BB-8-Senior-Design/pcb/Main_Board.brd

## EAGLE design Main_Board.brd (2016-10-18)

Schematic: Main_Board.sch

Parts:
C1, C3: 10uF; RADIAL_CAN_SMD-B
C2, C4, C5: 100uF; RADIAL_CAN_SMD-D8
C6, C7, C42: 470nF; 0805
C8, C9: 470uF; RADIAL_CAN_SMD-G
C10, C61, C68: 1uF; 0805
C11: .1uF; 0805
C12, C13: 6.8pF; 0805
C14, C15: 20pF; 0805
C16, C20, C21, C22, C23, C24, C41: 100nF; 0805
C17, C18, C56, C70: 2.2uF; 0805
C19, C63: 10uF; 0805
C25, C38, C39: 4.7uF; 0805
C26, C35, C36, C37, C46, C47, C48, C49, C50, C51, C52, C53, C54, C55, C57, C58, C59, C60, C62, C64, C66, C67, C69, C73, C74, C75, C76, C77, C78: 0.1uF; 0805
C27: 270nF; 0805
C28: 2.7nF; 0805
C29, C32: 22nF; 0805
C30, C31: 10nF; 0805
C33, C34: 0.47uF; 0805
C40: 150pF; 0805
C43: 10pF; 0805
C44: 47uF; 1206-CAP
C45, C72: 22uF; 0805
C65: 1.5uF; 0805
C71: 22pF; 0805
D1: SCHOTTKY_DIODE; DO-214AB2
D2: GREEN; LED-0603
D3: BAS16-SOT3; SOT23-3
D4, D6: MBRA140; SMA-DIODE
D5: D-1206; 1206-DIODE
F1, F2, F3: 4A; PTC-2920
FRAME1, FRAME2, FRAME3, FRAME4, FRAME5, FRAME6, FRAME7, FRAME8: FRAME-LEDGER; CREATIVE_COMMONS
J1: SERVO; 1X03
J2: 5.5x2.1mm Barrel; POWER_JACK_SMD
J3: 2-PIN-JUMPER; JST-2-PTH-VERT
J4: BATTERY; JST-4-PTH-VERT
J5: SPEAKER; JST-2-PTH-VERT
J6: SDIO-SDCARD; SD-5738
J7: M05PTH; 1X05
J8: M01PTH_NO_SILK_YES_STOP; 1X01_NO_SILK
JP1: REG_BOOT; 1X03
JP2: IGNORE_CC; 1X03
L1: 100uH; SRN8040
L2: 3.3uH; SPM6530
L3: 2.2uH; SPM6530
LED1, LED2, LED3, LED4, LED7, LED8: LED1206; LED-1206
P1, P2: MOTOR_HEADER; 1X06
P3: JTAG; IDC20
Q1: SI9933CDY-PFET; SO08
Q2, Q3, Q4, Q5, Q6, Q7, Q8: CSD17308Q3; SON-8
R1, R2, R3, R4, R5, R6: 4.7K; 0805
R7: .756K; 0805
R8: .768K; 0805
R9: .244K; 0805
R10: .232K; 0805
R11, R17, R18, R19, R20, R21, R24: 10K; 0805
R12, R13, R14, R75: 0; 0805
R15: 220; 0805
R16, R39, R45, R46, R47, R48, R49, R57, R58, R60, R63, R64, R66, R77, R79, R80, R81, R82: 100; 0805
R22, R23, R25, R74: 1K; 0805
R26: 66; 0805
R27: 196; 0805
R28: 20k; 0805
R29: 4.7k; 0805
R30, R31, R68: 100k; 0805
R32: 1500; 0805
R33: 57.6k; 0805
R34: 365k; 0805
R35: 1.3M; 0805
R36: 113k; 0805
R37, R38, R41, R65: 1k; 0805
R40, R51, R53, R54, R56, R62: 5.1k; 0805
R42: 5m; 0805
R43: 10; 0805
R44, R50: 150k; 0805
R52, R55, R59: 10M; 0805
R61, R71: 10k; 0805
R67: 1; 0805
R69: 2; 0805
R70: 10m; 0805
R72: 332k; 0805
R73: 35.63k; 0805
R76: 9.7K; 0805
R78: 3.3K; 0805
RT1: 10K-NTC; 0805
RT2: 10k-NTC; 0805
RT3, RT4, RT5: 10k; 0805
S1: RESET_BUTTON; 5.2X5.2
S2: SWITCH
U1: LMS8117; SOT-223
U2: 5V_BUCK_REG; T0-263-6
U3, U4: BTM7752G; 36-BSSOP
U5, U6: SN74LV4T125; 14-TSSOP
U7: STM32F405RGT6; LQFP64
U8: RN4020RN4020; RN4020
U9: BQ51013B-20VQFN; 20-VQFN
U10: IMU; IMU_BREAKOUT
U11: LTC3122-MSOP; MSOP-12_GND
U12: CBAT54S-SOT23-3; SOT23-3
U13: BQ2947; WSON-8
U14: TPA2005D1DGN; POWER-SOP8
U15: BQ40Z60; S-PVQFN-N32
U$1: XT60
Y1: 32.768KHz; 4-SMD,J-LEAD
Y2: 25MHz; 4-SMD,J-LEAD-2
Z2: DDZ16ASF-7; SOD-323F
Z3, Z4, Z5: MM3Z75VC; SOD-323F

Connections:
3.3V: C3.P$1 (+), C10.2, C16.2, C19.1, C20.1, C21.1, C22.1, C23.1, C24.1, C25.2, C61.1, J6.P$4 (VCC), J7.5, JP1.3 (S), P3.P$1 (VDD), P3.P$2 (VDD), R74.2, U1.P$2 (VOUT), U1.P$4 (VOUT), U5.P$14 (VCC), U7.P$1 (VBAT), U7.P$13 (VDDA), U7.P$19 (VDD), U7.P$32 (VDD), U7.P$48 (VDD), U7.P$64 (VDD), U8.P$23 (VDD), U10.3.3V (VCC), U10.CS_AG, U10.CS_M, U14.6 (VDD)
5V: C1.P$1 (+), C8.P$1 (+), C9.P$1 (+), J1.2, L1.P$1 (1), P1.VCC, P2.VCC, U1.P$3 (VIN), U2.P$4 (FEEDBACK), U6.P$13 (4!OE), U6.P$14 (VCC)
12V_BAT: F1.1, F3.1, J4.1, R37.1, R39.2, R43.1, R45.1, S2.P$4 (O)
12V_CC: C62.2, C67.1, C69.1, C71.2, C72.2, JP2.3 (S), Q4.P$1 (S1), Q4.P$2 (S1), Q4.P$3 (S1), R55.1, R70.1, R72.2, U15.P$19 (HSRN)
!NRST: P3.P$15 (NRST), R82.1, S1.P$1 (O), S1.P$2 (O), U7.P$7 (!RST)
AC1: C27.2, C28.1, C29.1, C30.1, C34.1, U9.P$2 (AC1)
AC2: C28.2, C31.1, C32.1, C33.1, J3.1, U9.P$19 (AC2)
AUDIO+: J5.2, U14.5 (OUT+)
AUDIO-: J5.1, U14.8 (OUT-)
AUDIO_PWM: R81.1, U7.P$21 (PA5)
BATT: R76.2, R78.1, U7.P$24 (PC4)
BLUE_WAKE_SW: U7.P$20 (PA4), U8.P$7 (WAKE_SW)
BLU_CMD: U7.P$27 (PB1), U8.P$8 (CMD/MLDP)
BLU_CTS: U7.P$15 (PA1), U8.P$14 (PIO5)
BLU_RTS: U7.P$14 (PA0_WKUP), U8.P$18 (RTS/PIO6)
BLU_RX: J7.3, U7.P$16 (PA2), U8.P$6 (UART_RX)
BLU_TX: J7.4, U7.P$17 (PA3), U8.P$5 (UART_TX)
BLU_WAKE_HW: J7.2, U7.P$22 (PA6), U8.P$15 (WAKE_HW)
BOOT2: C31.2, U9.P$17 (BOOT2)
CHRG_GPIO_SYSPRES: R65.2, U7.P$42 (PA9)
CHRG_I2C_SCL: R63.2, U7.P$29 (PB10)
CHRG_I2C_SDA: R64.2, U7.P$30 (PB11)
CHRG_I2C_SMBA: R66.2, U7.P$33 (PB12)
GND: C1.P$2 (-), C2.P$2 (-), C3.P$2 (-), C4.P$2 (-), C5.P$2 (-), C6.2, C7.2, C8.P$2 (-), C9.P$2 (-), C10.1, C11.1, C12.1, C13.1, C14.1, C15.1, C16.1, C17.2, C18.2, C19.2, C20.2, C21.2, C22.2, C23.2, C24.2, C25.1, C46.2, C48.2, C49.1, C51.2, C55.2, C56.2, C57.2, C58.2, C59.2, C61.2, C63.1, C65.2, C66.2, C67.2, C68.1, C74.1, C75.2, C76.2, C77.2, D1.A, J1.3, J4.4, J6.P$3 (GND), J6.P$6 (GND), J7.1, JP1.1 (O), LED1.C, LED2.C, LED3.C, LED4.C, P1.GND, P2.GND, P3.P$4 (GND), P3.P$6 (GND), P3.P$8 (GND), P3.P$10 (GND), P3.P$12 (GND), P3.P$14 (GND), P3.P$16 (GND), P3.P$18 (GND), P3.P$20 (GND), Q2.P$1 (S1), Q2.P$2 (S1), Q2.P$3 (S1), R9.2, R10.2, R16.2, R17.1, R18.1, R19.1, R20.1, R21.1, R24.1, R42.1, R49.1, R51.2, R71.2, R73.1, R75.2, R77.2, R78.2, RT2.2, RT3.2, RT4.2, RT5.2, S1.P$3, S1.P$4, U1.P$1 (ADJ/GND), U2.P$3 (GND), U2.P$5 (!ON/OFF), U2.P$6 (GND), U2.P$7 (GND), U2.P$8 (GND), U3.P$5 (GND), U3.P$6 (GND), U3.P$7 (GND), U3.P$8 (GND), U3.P$23 (GND), U3.P$24 (GND), U3.P$25 (GND), U3.P$26 (GND), U4.P$5 (GND), U4.P$6 (GND), U4.P$7 (GND), U4.P$8 (GND), U4.P$23 (GND), U4.P$24 (GND), U4.P$25 (GND), U4.P$26 (GND), U5.P$1 (1!OE), U5.P$4 (2!OE), U5.P$7 (GND), U5.P$10 (3!OE), U5.P$13 (4!OE), U6.P$1 (1!OE), U6.P$4 (2!OE), U6.P$7 (GND), U6.P$10 (3!OE), U6.P$12 (4A), U7.P$12 (VSSA), U7.P$18 (VSS), U7.P$63 (VSS), U8.P$1 (GND), U8.P$24 (GND), U10.GND, U13.P$6 (VSS), U13.P$GND (GNDPAD), U14.7 (GND), U14.9 (GND), U15.P$9 (VSS), U15.P$24 (PGND), U15.P$33 (PGND), U15.P$34 (PGND), U15.P$35 (PGND), U15.P$36 (PGND), U15.P$37 (PGND), U15.P$38 (PGND), U15.P$39 (PGND), U15.P$40 (PGND), U15.P$41 (PGND), U15.P$GND (VSS), U$1.P$1 (GND), Z3.1 (A), Z4.1 (A), Z5.1 (A)
IMU_I2C_SCL: U7.P$61 (PB8), U10.SCL
IMU_I2C_SDA: U7.P$59 (PB7), U10.SDA
IMU_SDO_AG: U7.P$10 (PC2), U10.SDO_AG
IMU_SDO_M: U7.P$11 (PC3), U10.SDO_M
JNTRST: P3.P$3 (JNTRST), U7.P$56 (PB4)
JTCK: P3.P$9 (JTCK), U7.P$49 (PA14)
JTDI: P3.P$5 (JTDI), U7.P$50 (PA15)
JTDO: P3.P$13 (JTDO), U7.P$55 (PB3)
JTMS: P3.P$7 (JTMS), U7.P$46 (PA13)
M1_A_3.3: U5.P$3 (1Y), U7.P$23 (PA7)
M1_A_5: P1.A, U5.P$2 (1A)
M1_B_3.3: U5.P$6 (2Y), U7.P$34 (PB13)
M1_B_5: P1.B, U5.P$5 (2A)
M2_A_3.3: U5.P$11 (4Y), U7.P$25 (PC5)
M2_A_5: P2.A, U5.P$12 (4A)
M2_B_3.3: U5.P$8 (3Y), U7.P$26 (PB0)
M2_B_5: P2.B, U5.P$9 (3A)
MC1_IN1: R1.1, U7.P$38 (PC7)
MC1_IN2: R3.1, U7.P$37 (PC6)
MC1_INH_3.3: U6.P$2 (1A), U7.P$40 (PC9)
MC1_INH_5: R5.2, U6.P$3 (1Y)
MC1_IS: R7.2, R9.1, U7.P$8 (PC0)
MC2_IN1: R2.2, U7.P$58 (PB6)
MC2_IN2: R4.1, U7.P$62 (PB9)
MC2_INH_3.3: U6.P$5 (2A), U7.P$45 (PA12)
MC2_INH_5: R6.2, U6.P$6 (2Y)
MC2_IS: R8.2, R10.1, U7.P$9 (PC1)
unnamed: P1.MOTOR+, U3.P$1 (OUT1), U3.P$2 (OUT1), U3.P$3 (OUT1), U3.P$4 (OUT1), U3.P$33 (OUT1), U3.P$34 (OUT1), U3.P$35 (OUT1), U3.P$36 (OUT1)
unnamed: P1.MOTOR-, U3.P$15 (OUT2), U3.P$16 (OUT2), U3.P$17 (OUT2), U3.P$18 (OUT2), U3.P$19 (OUT2), U3.P$20 (OUT2), U3.P$21 (OUT2), U3.P$22 (OUT2)
unnamed: R1.2, U3.P$9 (IN1)
unnamed: R3.2, U3.P$10 (IN2)
unnamed: R7.1, U3.P$28 (IS)
unnamed: R5.1, U3.P$27 (INH)
unnamed: R19.2, U8.P$2 (AIO2)
unnamed: P2.MOTOR+, U4.P$1 (OUT1), U4.P$2 (OUT1), U4.P$3 (OUT1), U4.P$4 (OUT1), U4.P$33 (OUT1), U4.P$34 (OUT1), U4.P$35 (OUT1), U4.P$36 (OUT1)
unnamed: P2.MOTOR-, U4.P$15 (OUT2), U4.P$16 (OUT2), U4.P$17 (OUT2), U4.P$18 (OUT2), U4.P$19 (OUT2), U4.P$20 (OUT2), U4.P$21 (OUT2), U4.P$22 (OUT2)
unnamed: R2.1, U4.P$9 (IN1)
unnamed: R4.2, U4.P$10 (IN2)
unnamed: C12.2, R12.2, Y1.P$1
unnamed: R8.1, U4.P$28 (IS)
unnamed: R6.1, U4.P$27 (INH)
unnamed: C17.1, U7.P$47 (VCAP_2)
unnamed: C18.1, U7.P$31 (VCAP_1)
unnamed: C15.2, R15.2, Y2.P$4
unnamed: C13.2, R13.2, Y1.P$2
unnamed: R14.1, U7.P$5 (PH0)
unnamed: C14.2, R14.2, Y2.P$1
unnamed: R13.1, U7.P$4 (PC15)
unnamed: R11.2, U7.P$60 (BOOT0)
unnamed: JP1.2, R11.1
unnamed: P3.P$11, R20.2
unnamed: P3.P$17, R21.2
unnamed: P3.P$19, R24.2
unnamed: F3.2, JP2.1 (O)
unnamed: R17.2, U8.P$4 (AIO0)
unnamed: R12.1, U7.P$3 (PC14)
unnamed: R15.1, U7.P$6 (PH1)
unnamed: D1.C, L1.P$2 (2), U2.P$2 (OUTPUT)
unnamed: S2.P$3, U$1.P$2 (+12V)
unnamed: J4.3, R41.2, R47.1
unnamed: R22.2, U8.P$10 (PIO1)
unnamed: LED1.A, R22.1
unnamed: R23.2, U8.P$11 (PIO2)
unnamed: R25.2, U8.P$12 (PIO3)
unnamed: LED2.A, R23.1
unnamed: LED3.A, R25.1
unnamed: C47.1, R37.2, U13.P$2 (V4), U13.P$3 (V3)
unnamed: LED8.A, U7.P$2 (PC13)
unnamed: LED4.A, R74.1
unnamed: J8.1, U7.P$52 (PC11)
unnamed: C77.1, R80.1, R81.2
unnamed: C76.1, R79.1, R80.2
unnamed: C47.2, C78.1, R38.2, U13.P$4 (V2)
unnamed: C50.1, C75.1, R79.2
unnamed: R18.2, U8.P$3 (AIO1)
unnamed: F1.2, F2.1, Q2.P$5 (D1), Q2.P$6 (D1), Q2.P$7 (D1), Q2.P$8 (D1), Q2.P$9 (D1)
unnamed: C40.1, R34.1
unnamed: C39.1, U11.4 (PWM/SYNC), U11.5 (VCC)
unnamed: R33.2, U11.6 (RT)
unnamed: C42.1, L2.P$2 (2), U11.1 (SW)
unnamed: C32.2, U9.P$15 (COMM2)
unnamed: C33.2, U9.P$16 (CLAMP2)
unnamed: C34.2, U9.P$5 (CLAMP1)
unnamed: C30.2, U9.P$3 (BOOT1)
unnamed: C29.2, U9.P$6 (COMM1)
unnamed: C27.1, J3.2
unnamed: R26.1, U9.P$12 (ILIM)
unnamed: R26.2, R27.1, R28.1, U9.P$14 (FOD)
unnamed: C35.1, R28.2, U9.P$18 (RECT)
unnamed: R32.2, U9.P$7 (!CHG)
unnamed: R50.2, U14.4 (IN-)
unnamed: C50.2, R44.1
unnamed: C51.1, R50.1
unnamed: R44.2, U14.3 (IN+)
unnamed: RT2.1, U15.P$10 (TS1)
unnamed: RT3.1, U15.P$11 (TS2)
unnamed: RT4.1, U15.P$12 (TS3)
unnamed: RT5.1, U15.P$13 (TS4)
unnamed: R66.1, U15.P$14 (ALERT/BTP)
unnamed: R57.1, U15.P$15 (SYSPRES)
unnamed: R57.2, R65.1, Z3.2 (C)
unnamed: R58.1, U15.P$16 (SMBD)
unnamed: R58.2, R64.1, Z4.2 (C)
unnamed: R60.1, U15.P$17 (SMBC)
unnamed: R60.2, R63.1, Z5.2 (C)
unnamed: C71.1, R72.1, R73.2, U15.P$18 (VFB)
unnamed: C66.1, C69.2, L3.P$2 (2), Q5.P$1 (S1), Q5.P$2 (S1), Q5.P$3 (S1), R70.2, U15.P$20 (HSRP)
unnamed: D6.A, Q8.P$4 (G1), R71.1
unnamed: Q6.P$4 (G1), Q8.P$5 (D1), Q8.P$6 (D1), Q8.P$7 (D1), Q8.P$8 (D1), Q8.P$9 (D1), R56.1, R59.2
unnamed: R56.2, U15.P$29 (ACFET)
unnamed: C73.1, C74.2
unnamed: C64.1, D4.C, U15.P$28 (BTST)
unnamed: C65.1, D4.A, U15.P$23 (REGN)
unnamed: C64.2, L3.P$1 (1), Q7.P$5 (D1), Q7.P$6 (D1), Q7.P$7 (D1), Q7.P$8 (D1), Q7.P$9 (D1), U15.P$26 (PH)
unnamed: C55.1, Q2.P$4 (G1), R40.2, R51.1, R62.2
unnamed: C68.2, R67.1, U15.P$22 (VCC)
unnamed: R62.1, U15.P$21 (AFEFUSE)
unnamed: D5.D (C), D6.C
unnamed: C70.2, R69.2
unnamed: Q7.P$4 (G1), U15.P$25 (LODRV)
unnamed: C63.2, Q5.P$5 (D1), Q5.P$6 (D1), Q5.P$7 (D1), Q5.P$8 (D1), Q5.P$9 (D1), Q6.P$5 (D1), Q6.P$6 (D1), Q6.P$7 (D1), Q6.P$8 (D1), Q6.P$9 (D1), R67.2
unnamed: Q5.P$4 (G1), U15.P$27 (HIDRV)
unnamed: R54.2, U15.P$31 (DSG)
unnamed: Q4.P$4 (G1), R54.1, R55.2
unnamed: R61.2, U15.P$30 (ACP)
unnamed: Q3.P$5 (D1), Q3.P$6 (D1), Q3.P$7 (D1), Q3.P$8 (D1), Q3.P$9 (D1), Q4.P$5 (D1), Q4.P$6 (D1), Q4.P$7 (D1), Q4.P$8 (D1), Q4.P$9 (D1)
unnamed: C60.2, C62.1
unnamed: C60.1, F2.2, Q3.P$1 (S1), Q3.P$2 (S1), Q3.P$3 (S1), R52.1
unnamed: Q3.P$4 (G1), R52.2, R53.1
unnamed: R53.2, U15.P$32 (CHG)
unnamed: LED8.C, R16.1
unnamed: D3.3, U15.P$1 (BAT)
unnamed: D3.1, R43.2
unnamed: C56.1, U15.P$2 (PBI)
unnamed: C54.1, R45.2, U15.P$3 (VC4), U15.P$4 (VC3)
unnamed: C41.2, U11.12 (CAP)
unnamed: C53.1, C54.2, R46.2, U15.P$5 (VC2)
unnamed: C53.2, C57.1, R47.2, U15.P$6 (VC1)
unnamed: C52.1, C58.1, R48.2, U15.P$7 (SRN)
unnamed: C52.2, C59.1, R49.2, U15.P$8 (SRP)
unnamed: R40.1, U13.P$8 (OUT)
unnamed: D2.C, R32.1
unnamed: J4.2, R38.1, R46.1
unnamed: R35.1, R36.2, U11.8 (FB)
unnamed: C46.1, R39.1, U13.P$1 (VDD)
unnamed: C43.1, R34.2, U11.7 (VC)
unnamed: C42.2, U12.3
unnamed: C49.2, C78.2, R41.1, U13.P$5 (V1)
unnamed: C48.1, U13.P$7 (CD)
unnamed: C44.2, U12.1, Z2.1 (A)
unnamed: C37.1, R29.1, R30.1, R31.1, U9.P$13 (TS/CTRL)
unnamed: Q1.2 (G), Q1.4 (G), U9.P$8 (!AD-EN)
unnamed: R29.2, RT1.1
unnamed: Q1.1 (S), Q1.3 (S)
unnamed: C26.1, J2.VIN0 (PWR), Q1.7 (D), Q1.8 (D), U9.P$9 (AD)
unnamed: C11.2, R82.2
unnamed: LED7.A, U7.P$57 (PB5)
unnamed: LED7.C, R77.1
PACK+: C41.1, C45.1, C73.2, D5.A, Q6.P$1 (S1), Q6.P$2 (S1), Q6.P$3 (S1), Q8.P$1 (S1), Q8.P$2 (S1), Q8.P$3 (S1), R35.2, R59.1, R61.1, R68.1, R69.1, U11.11 (V_OUT)
PACK-: R42.2, R48.1
PGND: C26.2, C35.2, C36.2, C37.2, C38.2, C39.2, C40.2, C43.2, C44.1, C45.2, C70.1, C72.1, J2.GND (GNDBREAK), J2.P$4 (GND), Q7.P$1 (S1), Q7.P$2 (S1), Q7.P$3 (S1), R27.2, R30.2, R31.2, R33.1, R36.1, R68.2, R75.1, RT1.2, U9.P$1 (PGND), U9.P$10 (EN1), U9.P$11 (EN2), U9.P$20 (PGND), U9.P$21 (PGND), U9.P$22 (PGND), U9.P$23 (PGND), U9.P$24 (PGND), U9.P$25 (PGND), U9.P$26 (PGND), U9.P$27 (PGND), U11.2 (PGND), U11.10 (SGND), U11.13 (PGND), U11.P$1 (PGND), U11.P$2 (PGND), U11.P$3 (PGND), U11.P$4 (PGND), U11.P$5 (PGND), U11.P$6 (PGND), U12.2, Z2.2 (C)
SDIO_CK: J6.P$5 (CLK), U7.P$53 (PC12)
SDIO_CMD: J6.P$2 (CMD), U7.P$54 (PD2)
SDIO_D0: J6.P$7 (DATA), U7.P$39 (PC8)
SERVO_PWM_3.3: U6.P$9 (3A), U7.P$41 (PA8)
SERVO_PWM_5: J1.1, U6.P$8 (3Y)
SPEAKER_SHUTDOWN: U7.P$28 (PB2), U14.1 (SHUTDOWN)
VCC: C2.P$1 (+), C4.P$1 (+), C5.P$1 (+), C6.1, C7.1, JP2.2, R76.1, U2.P$1 (VIN), U3.P$11 (VS), U3.P$12 (VS), U3.P$13 (VS), U3.P$14 (VS), U3.P$29 (VS), U3.P$30 (VS), U3.P$31 (VS), U3.P$32 (VS), U4.P$11 (VS), U4.P$12 (VS), U4.P$13 (VS), U4.P$14 (VS), U4.P$29 (VS), U4.P$30 (VS), U4.P$31 (VS), U4.P$32 (VS)
WIRELESS_OUT_5V: C36.1, C38.1, D2.A, L2.P$1 (1), Q1.5 (D), Q1.6 (D), U9.P$4 (OUT), U11.3 (V_IN), U11.9 (!SD)

Notes on the sheet:
Motor Controllers, Servo
Microcontroller
Power Conversion
Bluetooth
double check
Wireless Charging Receiver and 5 to 15V Converter
Audio Amplifier
SD Card Connection (SPI)
BQ40Z60 Charging Circuit
also known as ground
charging +
Should possibly be .065K or 10K
IMU
Can reduce resistors for greater gain

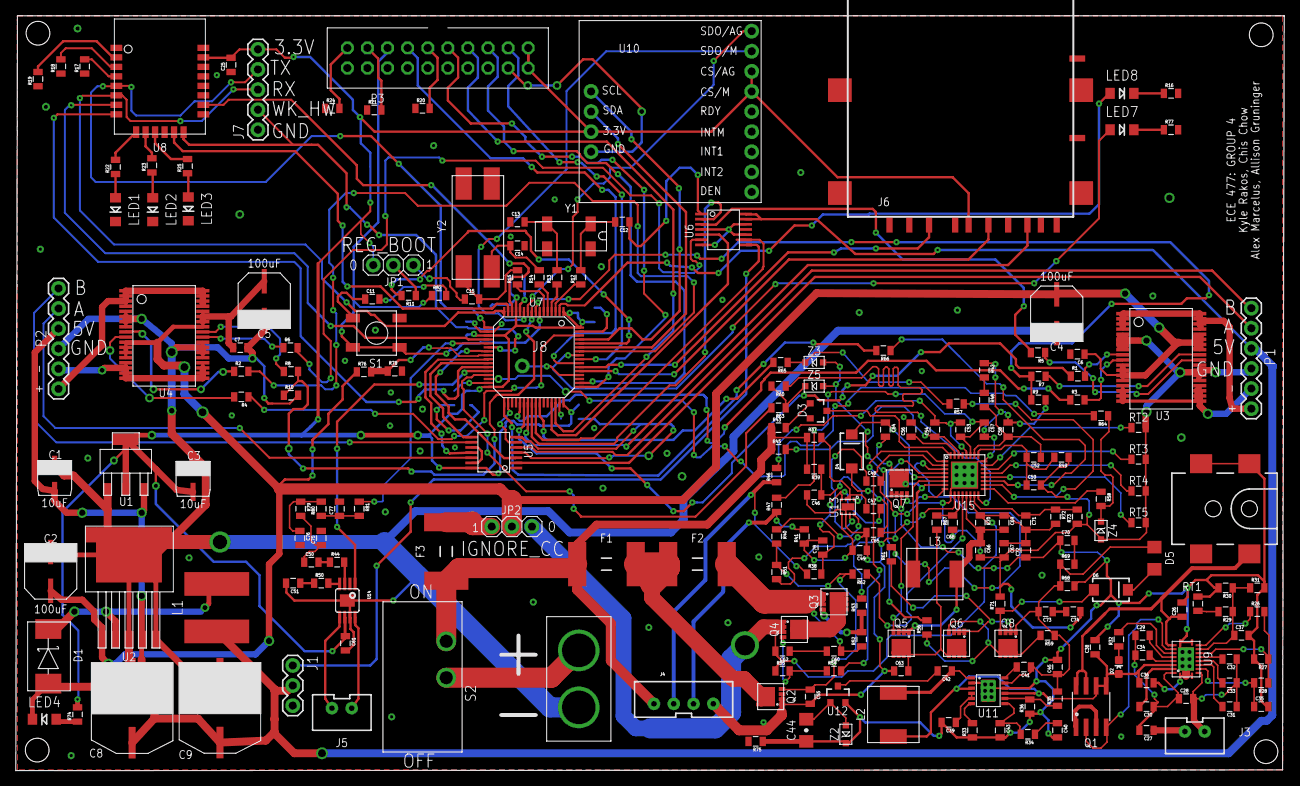
[picture p1: board Main_Board.brd from above]

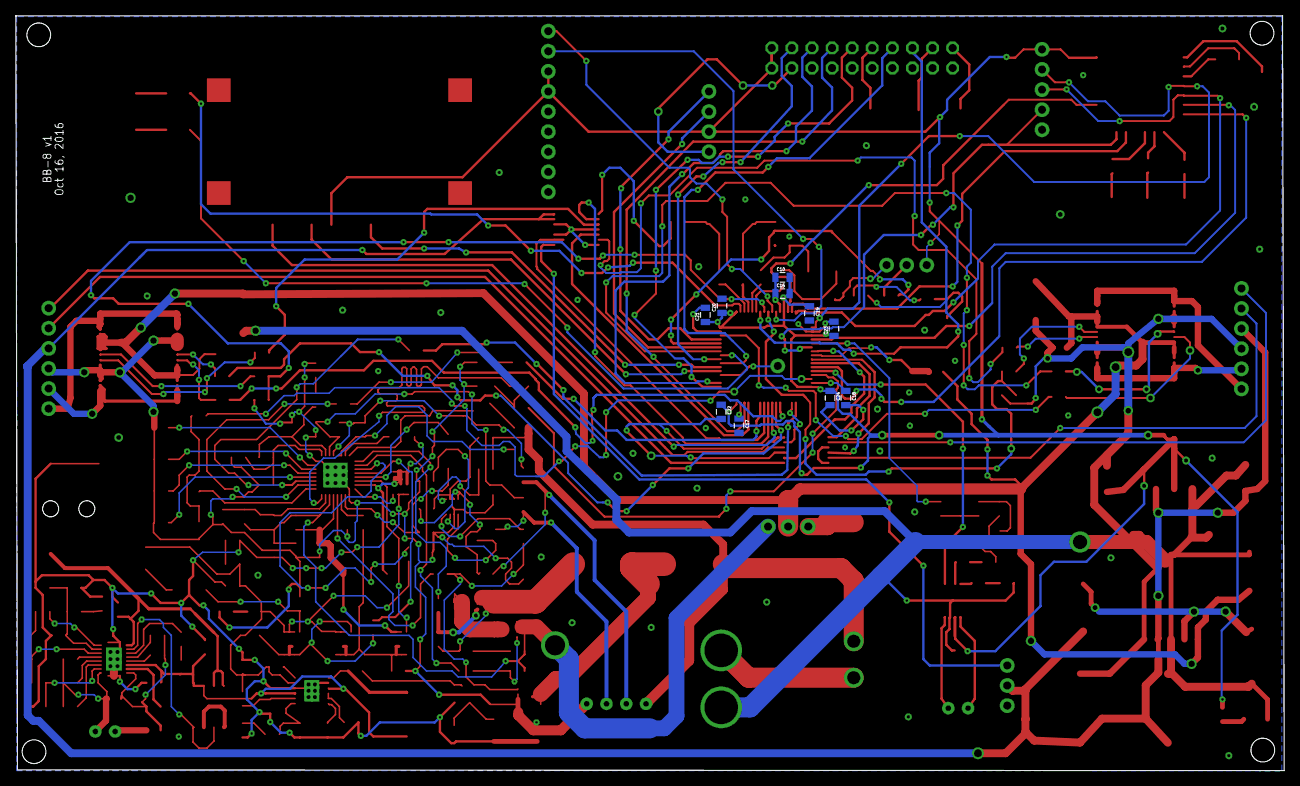
[picture p2: board Main_Board.brd from below]

Board: 2 copper layers, 160.3 x 95.4 mm, 236 parts (10 on the bottom side), 193 nets.
