BB-8-Senior-Design/pcb/Charging-old-separate/ChargingCircuit.brd

## EAGLE design Charging-old-separate/ChargingCircuit.brd (2016-09-23, an earlier design)

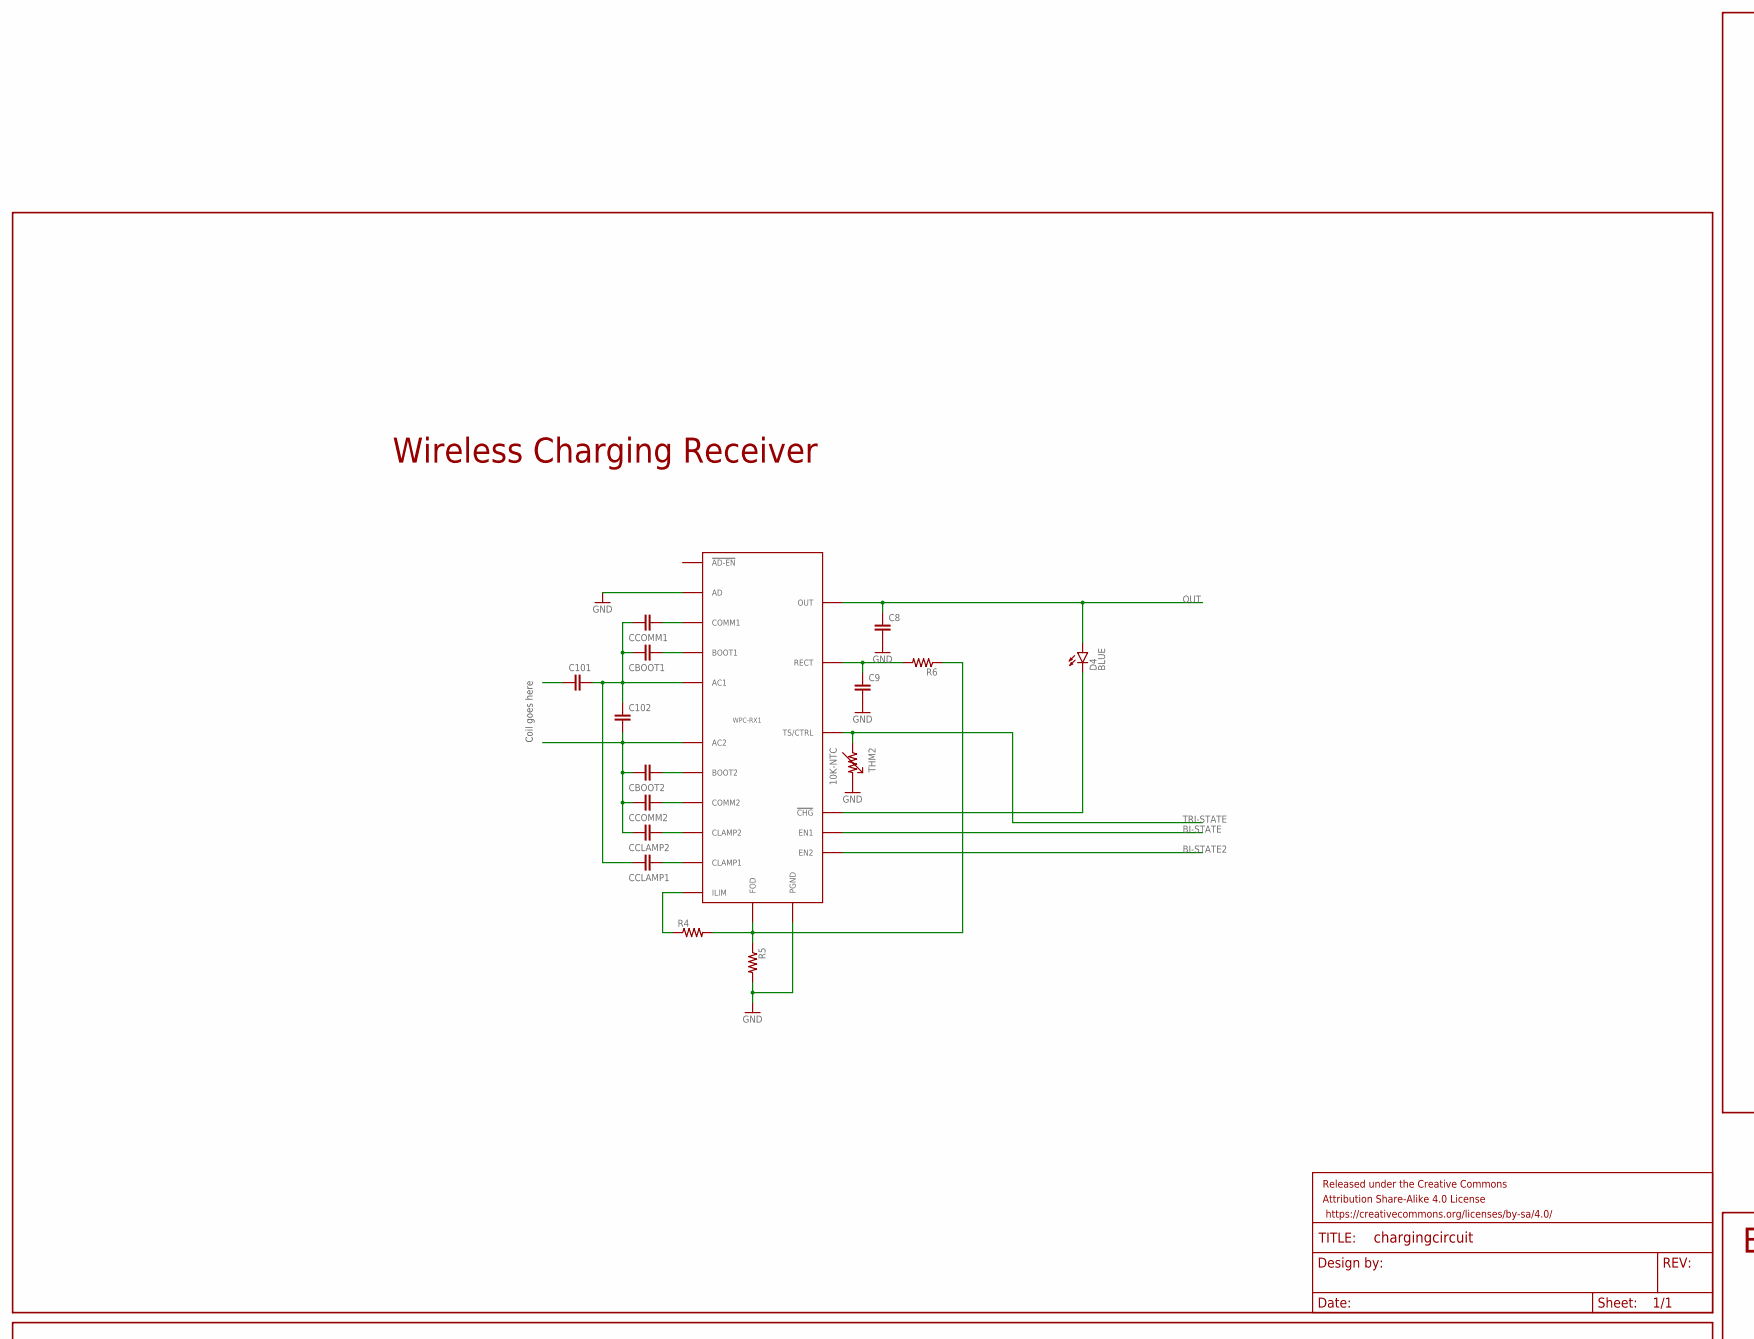
[picture p3: schematic ChargingCircuit.sch, part in row 1, column 1]

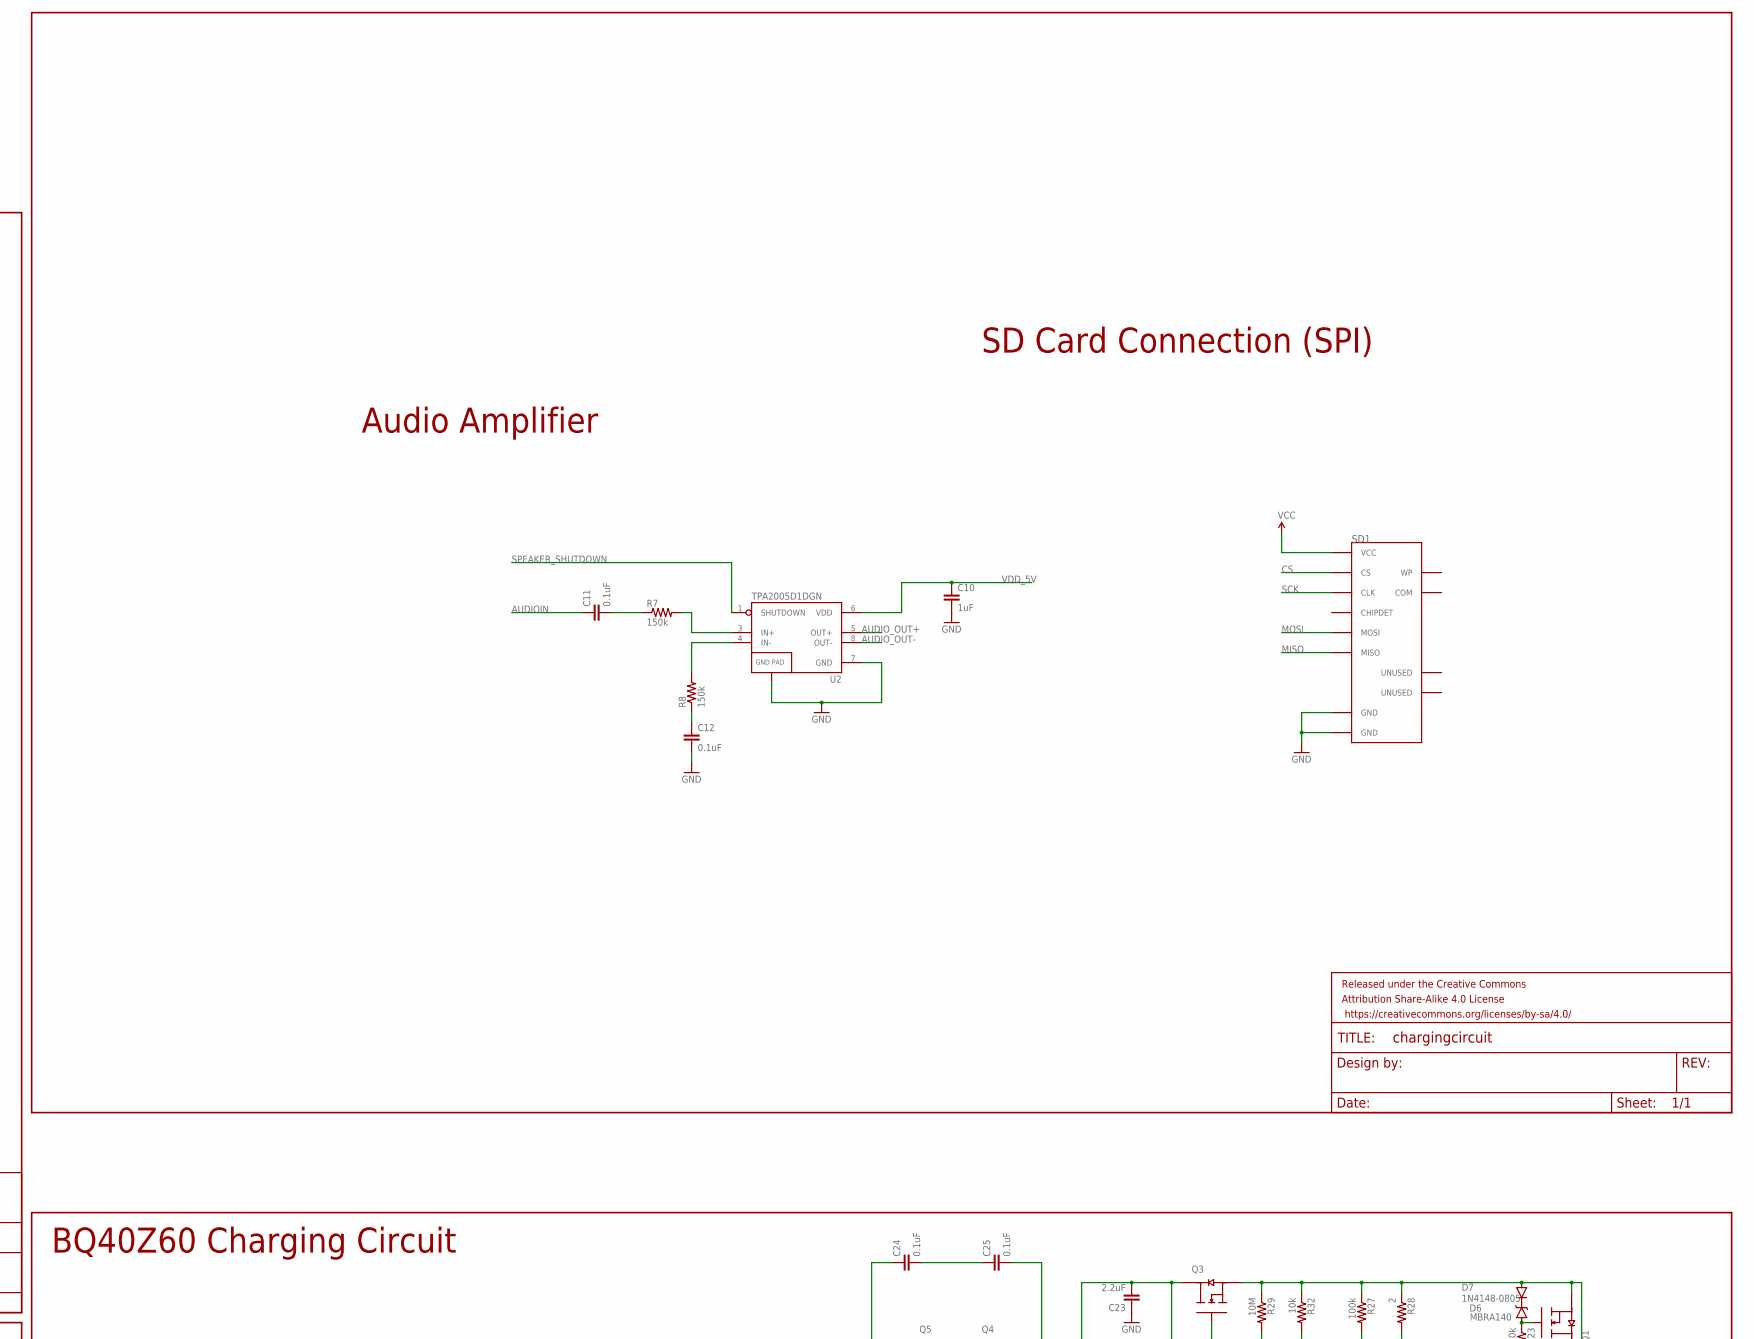
[picture p4: schematic ChargingCircuit.sch, part in row 1, column 2]

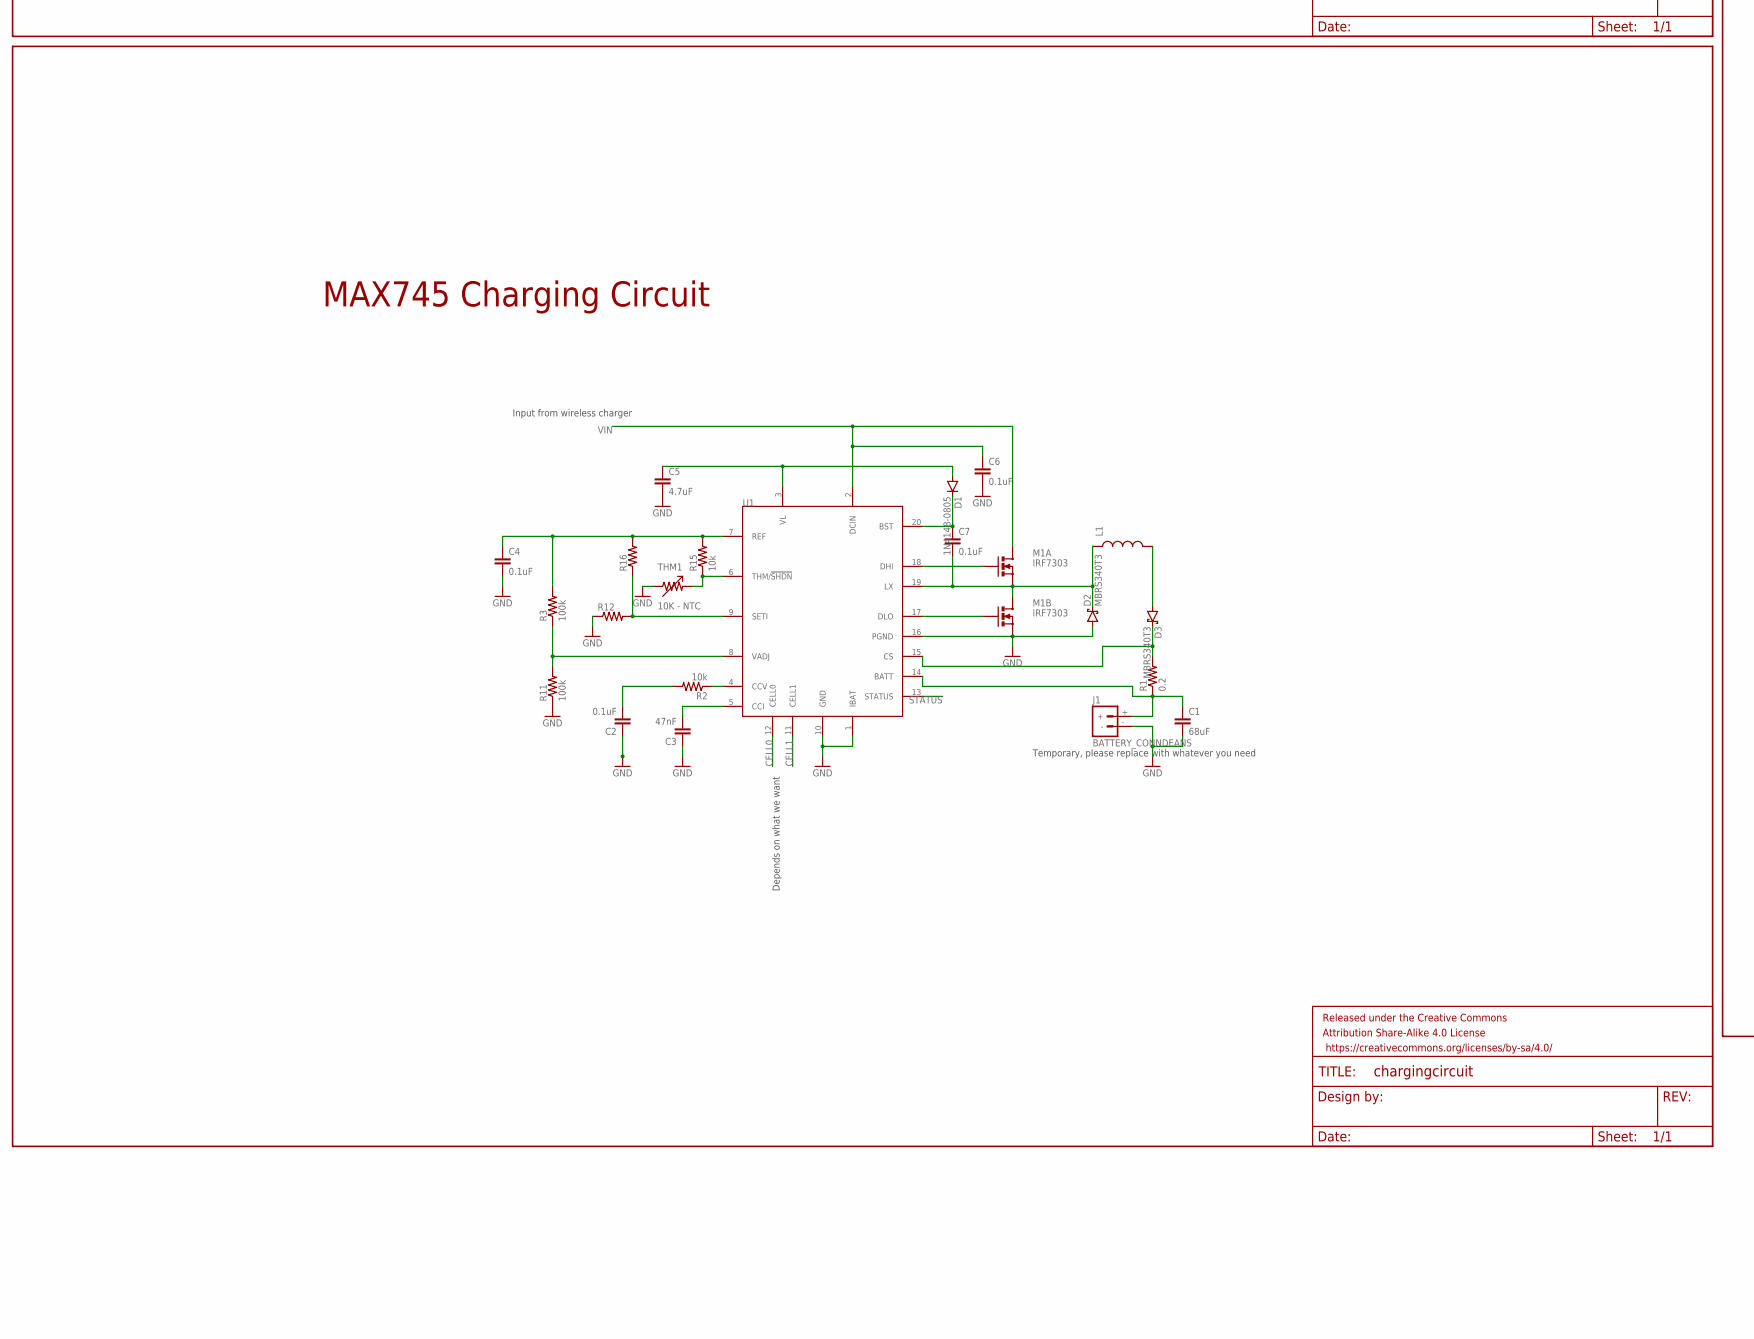
[picture p5: schematic ChargingCircuit.sch, part in row 2, column 1]

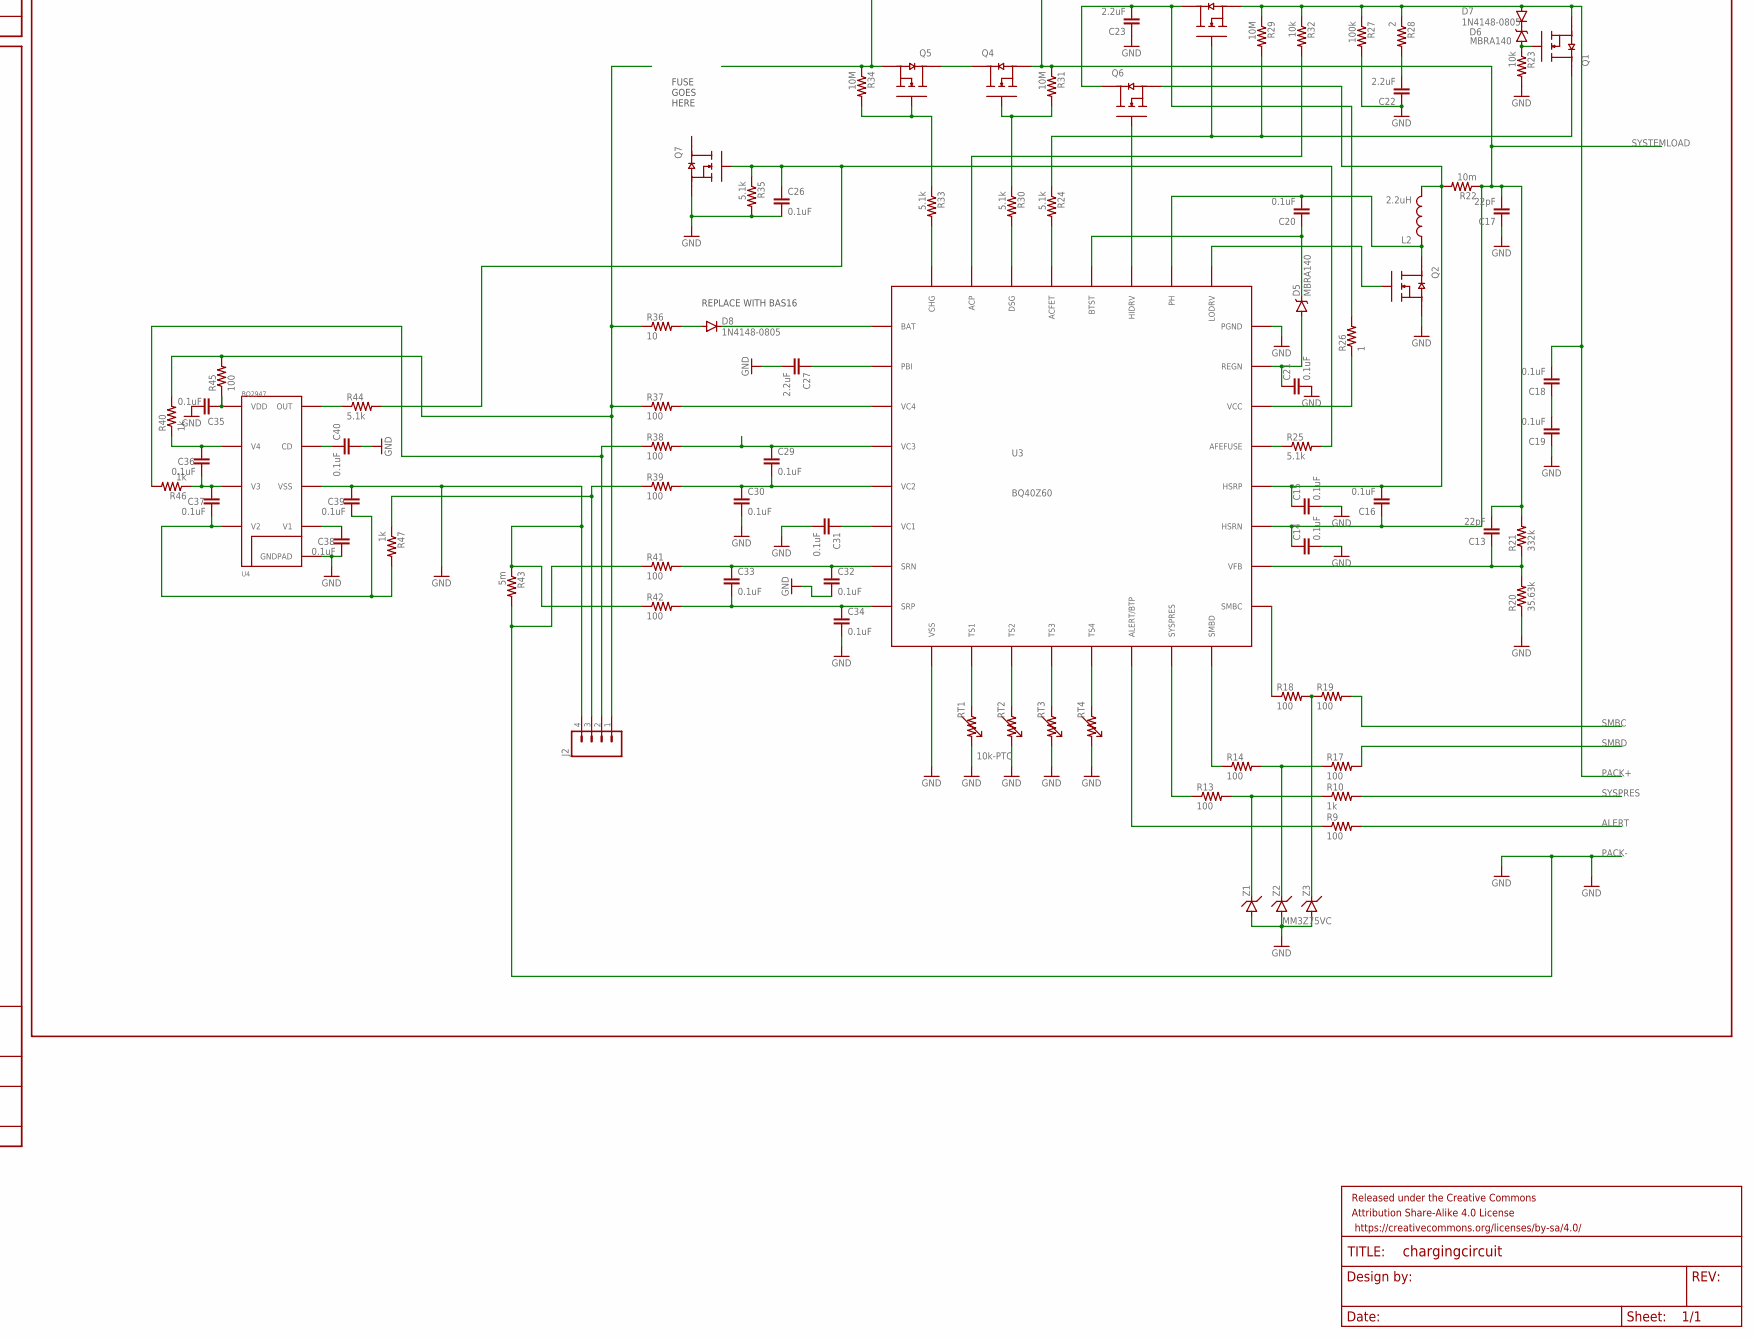
[picture p6: schematic ChargingCircuit.sch, part in row 2, column 2]

Parts:
C1: 68uF; 0805
C2, C4, C6, C7, C11, C12, C14, C15, C16, C18, C19, C20, C21, C24, C25, C26, C29, C30, C31, C32, C33, C34, C35, C36, C37, C38, C39, C40: 0.1uF; 0805
C3: 47nF; 0805
C5: 4.7uF; 0805
C8, C9, C101, C102: CAP0805; 0805
C10: 1uF; 0805
C13, C17: 22pF; 0805
C22, C23, C27: 2.2uF; 0805
CBOOT1, CBOOT2: CAP0805; 0805
CCLAMP1, CCLAMP2: CAP0805; 0805
CCOMM1, CCOMM2: CAP0805; 0805
D1, D7, D8: 1N4148-0805; 0805-DIODE
D2, D3: MBRS340T3; DO-214AB
D4: BLUE; LED-0603
D5, D6: MBRA140; SMA-DIODE
FRAME6, FRAME7, FRAME8, FRAME9: FRAME-LEDGER; CREATIVE_COMMONS
J1: BATTERY_CONNDEANS; DEANS
J2: M04JST; 1X04-1.5MM_JST
L1: INDUCTOR0805; 0805
L2: 2.2uH; 0805
M1: IRF7303; SO08
Q1, Q2, Q3, Q4, Q5, Q6, Q7: CSD17308Q3; SON-8
R1: 0.2; 0805
R2, R15, R23, R32: 10k; 0805
R3, R11, R27: 100k; 0805
R4, R5, R6, R12, R16: RESISTOR0805-RES; 0805
R7, R8: 150k; 0805
R9, R13, R14, R17, R18, R19, R37, R38, R39, R41, R42, R45: 100; 0805
R10, R40, R46, R47: 1k; 0805
R20: 35.63k; 0805
R21: 332k; 0805
R22: 10m; 0805
R24, R25, R30, R33, R35, R44: 5.1k; 0805
R26: 1; 0805
R28: 2; 0805
R29, R31, R34: 10M; 0805
R36: 10; 0805
R43: 5m; 0805
RT1: 10k-PTC; 0805
RT2, RT3, RT4: THM; 0805
SD1: 5738-SDCARD; SD-5738
THM1: 10K - NTC; 0805
THM2: 10K-NTC; 0805
U1: MAX745EACSSOP; SSOP20
U2: TPA2005D1DGN; POWER-SOP8
U3: BQ40Z60; S-PVQFN-N32
U4: BQ2947; WSON-8
WPC-RX1: BQ51013B-20VQFN; 20-VQFN
Z1, Z2, Z3: MM3Z75VC; SOD-323F

Connections:
AC1: C101.2, C102.1, CBOOT1.1, CCLAMP1.1, CCOMM1.1, WPC-RX1.P$2 (AC1)
AC2: C102.2, CBOOT2.1, CCLAMP2.1, CCOMM2.1, WPC-RX1.P$19 (AC2)
ALERT: R9.2
AUDIOIN: C11.1
AUDIO_OUT+: U2.5 (OUT+)
AUDIO_OUT-: U2.8 (OUT-)
BI-STATE: WPC-RX1.P$10 (EN1)
BI-STATE2: WPC-RX1.P$11 (EN2)
BOOT2: CBOOT2.2, WPC-RX1.P$17 (BOOT2)
CELL0: U1.12 (CELL0)
CELL1: U1.11 (CELL1)
CS: SD1.P$1 (CS)
GND: C1.2, C2.1, C3.1, C4.2, C5.2, C6.2, C8.2, C9.2, C10.2, C12.2, C14.2, C15.2, C17.1, C19.1, C21.2, C22.1, C23.1, C26.2, C27.2, C30.2, C31.2, C32.2, C34.2, C35.2, C38.2, C39.1, C40.2, D2.POS (A), J1.-, J2.4, M1.3 (S), Q2.P$1 (S1), Q2.P$2 (S1), Q2.P$3 (S1), Q7.P$1 (S1), Q7.P$2 (S1), Q7.P$3 (S1), R5.2, R11.1, R12.1, R20.1, R23.2, R27.2, R35.2, R42.1, R43.1, RT1.2, RT2.2, RT3.2, RT4.2, SD1.P$3 (GND), SD1.P$6 (GND), THM1.1, THM2.2, U1.1 (IBAT), U1.10 (GND), U1.16 (PGND), U2.7 (GND), U2.9 (GND), U3.P$9 (VSS), U3.P$24 (PGND), U3.P$GND (VSS), U4.P$6 (VSS), U4.P$GND (GNDPAD), WPC-RX1.P$1 (PGND), WPC-RX1.P$9 (AD), WPC-RX1.P$20 (PGND), Z1.1 (A), Z2.1 (A), Z3.1 (A)
MISO: SD1.P$7 (MISO)
MOSI: SD1.P$2 (MOSI)
unnamed: C5.1, D1.1 (A), U1.3 (VL)
unnamed: C7.1, D1.2 (C), U1.20 (BST)
unnamed: M1.2 (G), U1.18 (DHI)
unnamed: M1.4 (G), U1.17 (DLO)
unnamed: D3.NEG (C), R1.2, U1.15 (CS)
unnamed: D3.POS (A), L1.2
unnamed: C1.1, J1.+, R1.1, U1.14 (BATT)
unnamed: C7.2, D2.NEG (C), L1.1, M1.1 (S), M1.5 (D), M1.6 (D), U1.19 (LX)
unnamed: C3.2, U1.5 (CCI)
unnamed: R2.1, U1.4 (CCV)
unnamed: C2.2, R2.2
unnamed: C4.1, R3.2, R15.2, R16.2, U1.7 (REF)
unnamed: R12.2, R16.1, U1.9 (SETI)
unnamed: R15.1, THM1.2, U1.6 (THM/!SHDN)
unnamed: R3.1, R11.2, U1.8 (VADJ)
unnamed: CCOMM2.2, WPC-RX1.P$15 (COMM2)
unnamed: CCLAMP2.2, WPC-RX1.P$16 (CLAMP2)
unnamed: CCLAMP1.2, WPC-RX1.P$5 (CLAMP1)
unnamed: CBOOT1.2, WPC-RX1.P$3 (BOOT1)
unnamed: CCOMM1.2, WPC-RX1.P$6 (COMM1)
unnamed: R4.1, WPC-RX1.P$12 (ILIM)
unnamed: R4.2, R5.1, R6.1, WPC-RX1.P$14 (FOD)
unnamed: D4.C, WPC-RX1.P$7 (!CHG)
unnamed: C9.1, R6.2, WPC-RX1.P$18 (RECT)
unnamed: R7.2, U2.3 (IN+)
unnamed: C11.2, R7.1
unnamed: R10.1, R13.2, Z1.2 (C)
unnamed: R8.2, U2.4 (IN-)
unnamed: RT1.1, U3.P$10 (TS1)
unnamed: C12.1, R8.1
unnamed: RT2.1, U3.P$11 (TS2)
unnamed: RT3.1, U3.P$12 (TS3)
unnamed: RT4.1, U3.P$13 (TS4)
unnamed: R9.1, U3.P$14 (ALERT/BTP)
unnamed: Q1.P$5 (D1), Q1.P$6 (D1), Q1.P$7 (D1), Q1.P$8 (D1), Q3.P$4 (G1), R24.1, R29.2
unnamed: R13.1, U3.P$15 (SYSPRES)
unnamed: R14.1, U3.P$16 (SMBD)
unnamed: R14.2, R17.1, Z2.2 (C)
unnamed: C13.1, R20.2, R21.1, U3.P$18 (VFB)
unnamed: R24.2, U3.P$29 (ACFET)
unnamed: C18.1, C19.2
unnamed: R18.1, U3.P$17 (SMBC)
unnamed: R18.2, R19.1, Z3.2 (C)
unnamed: C15.1, C16.2, L2.2, Q6.P$1 (S1), Q6.P$2 (S1), Q6.P$3 (S1), R22.2, U3.P$20 (HSRP)
unnamed: R26.1, U3.P$22 (VCC)
unnamed: D6.A, Q1.P$4 (G1), R23.1
unnamed: C20.2, L2.1, Q2.P$5 (D1), Q2.P$6 (D1), Q2.P$7 (D1), Q2.P$8 (D1), U3.P$26 (PH)
unnamed: C20.1, D5.C, U3.P$28 (BTST)
unnamed: C21.1, D5.A, U3.P$23 (REGN)
unnamed: C23.2, Q3.P$5 (D1), Q3.P$6 (D1), Q3.P$7 (D1), Q3.P$8 (D1), Q6.P$5 (D1), Q6.P$6 (D1), Q6.P$7 (D1), Q6.P$8 (D1), R26.2
unnamed: R25.1, U3.P$21 (AFEFUSE)
unnamed: C26.1, Q7.P$4 (G1), R25.2, R35.1, R44.2
unnamed: Q6.P$4 (G1), U3.P$27 (HIDRV)
unnamed: D6.C, D7.2 (C)
unnamed: C22.2, R28.2
unnamed: Q2.P$4 (G1), U3.P$25 (LODRV)
unnamed: R30.2, U3.P$31 (DSG)
unnamed: Q4.P$4 (G1), R30.1, R31.2
unnamed: R32.2, U3.P$30 (ACP)
unnamed: Q4.P$5 (D1), Q4.P$6 (D1), Q4.P$7 (D1), Q4.P$8 (D1), Q5.P$5 (D1), Q5.P$6 (D1), Q5.P$7 (D1), Q5.P$8 (D1)
unnamed: C24.2, C25.1
unnamed: C24.1, Q5.P$1 (S1), Q5.P$2 (S1), Q5.P$3 (S1), R34.1
unnamed: Q5.P$4 (G1), R33.1, R34.2
unnamed: R33.2, U3.P$32 (CHG)
unnamed: C40.1, U4.P$7 (CD)
unnamed: J2.1, R36.1, R37.1, R40.2, R45.2
unnamed: D8.2 (C), U3.P$1 (BAT)
unnamed: D8.1 (A), R36.2
unnamed: C27.1, U3.P$2 (PBI)
unnamed: R37.2, U3.P$3 (VC4)
unnamed: C29.1, R38.2, U3.P$4 (VC3)
unnamed: C29.2, C30.1, R39.2, U3.P$5 (VC2)
unnamed: C31.1, U3.P$6 (VC1)
unnamed: C32.1, C33.1, R41.2, U3.P$7 (SRN)
unnamed: C33.2, C34.1, R42.2, U3.P$8 (SRP)
unnamed: R44.1, U4.P$8 (OUT)
unnamed: C36.1, R40.1, U4.P$2 (V4)
unnamed: J2.2, R38.1, R46.2
unnamed: J2.3, R39.1, R47.1
unnamed: C35.1, R45.1, U4.P$1 (VDD)
unnamed: C36.2, C37.1, R46.1, U4.P$3 (V3)
unnamed: C37.2, C39.2, R47.2, U4.P$4 (V2)
unnamed: C38.1, U4.P$5 (V1)
OUT: C8.1, D4.A, WPC-RX1.P$4 (OUT)
PACK+: C18.2, D7.1 (A), Q1.P$1 (S1), Q1.P$2 (S1), Q1.P$3 (S1), Q3.P$1 (S1), Q3.P$2 (S1), Q3.P$3 (S1), R27.1, R28.1, R29.1, R32.1
PACK-: R41.1, R43.2
SCK: SD1.P$5 (CLK)
SMBC: R19.2
SMBD: R17.2
SPEAKER_SHUTDOWN: U2.1 (SHUTDOWN)
STATUS: U1.13 (STATUS)
SYSPRES: R10.2
SYSTEMLOAD: C13.2, C14.1, C16.1, C17.2, C25.2, Q4.P$1 (S1), Q4.P$2 (S1), Q4.P$3 (S1), R21.2, R22.1, R31.1, U3.P$19 (HSRN)
TRI-STATE: THM2.1, WPC-RX1.P$13 (TS/CTRL)
VDD_5V: C10.1, U2.6 (VDD)
VIN: C6.1, M1.7 (D), M1.8 (D), U1.2 (DCIN)

Notes on the sheet:
MAX745 Charging Circuit
Wireless Charging Receiver
Audio Amplifier
Temporary, please replace with whatever you need
Coil goes here
Input from wireless charger
Depends on what we want
SD Card Connection (SPI)
BQ40Z60 Charging Circuit
REPLACE WITH BAS16
FUSE GOES HERE

Board: 2 copper layers, 133 parts (0 on the bottom side), 94 nets, no tracks yet.
