BB-8-Senior-Design/pcb/(commit log)

2016-09-17 Initial board
    [Main_Board.brd, Main_Board.sch]
2016-09-18 Added more parts
    [Main_Board.brd, Main_Board.sch]
2016-09-18 Added MAX745 circuit to pcb project
    [ChargingCircuit.brd, ChargingCircuit.sch]
2016-09-18 Updated board
    [Main_Board.brd, Main_Board.sch]
2016-09-18 minor changes to charging board
    [ChargingCircuit.brd, ChargingCircuit.sch]
2016-09-19 Started powering micro
    [Main_Board.brd, Main_Board.sch]
2016-09-19 Labeling MCs
    [Main_Board.brd, Main_Board.sch]
2016-09-19 Added leve; translation for motor stuff
    [Main_Board.brd, Main_Board.sch]
2016-09-21 Added oscilator to schematic
    [Main_Board.brd, Main_Board.sch]
2016-09-21 Added wireless charging board, speaker circuit
    [ChargingCircuit.brd, ChargingCircuit.sch]
2016-09-22 Added most remaining STM requirements
    [Main_Board.brd, Main_Board.sch]
2016-09-22 added more info for boards
    [ChargingCircuit.brd, ChargingCircuit.sch]
2016-09-22 added extra oscillator resistor
    [Main_Board.brd, Main_Board.sch]
2016-09-23 More work on SD card stuff; TODO: finish up calculations for charging circuit values
    [ChargingCircuit.sch]
2016-09-23 updated crystals
    [Main_Board.brd, Main_Board.sch]
2016-09-23 added buck regulator
    [Main_Board.brd, Main_Board.sch]
2016-09-23 added jtag
    [Main_Board.brd, Main_Board.sch]
2016-09-23 started adding motors
    [Main_Board.brd, Main_Board.sch]
2016-09-23 finished adding motors
    [Main_Board.brd, Main_Board.sch]
2016-09-23 Added cap values
    [Main_Board.brd, Main_Board.sch]
2016-09-23 Moved parts onto board
    [Main_Board.brd, Main_Board.sch]
2016-09-23 Added BQ40Z60 Charging Circuit
    [ChargingCircuit.brd, ChargingCircuit.sch]
2016-09-23 added IMU
    [Main_Board.brd, Main_Board.sch]
2016-09-23 Preliminary work on BQ40Z60, need to short VC3 and VC4, fix VC1
    [ChargingCircuit.brd, ChargingCircuit.sch]
2016-09-23 Combined boards -- death
    [Main_Board.brd, Main_Board.sch]
2016-09-23 Fixed BQ40Z60 for 3S configuration
    [Main_Board.brd, Main_Board.sch]
2016-09-23 Updated symbols for some parts to show value too
    [Main_Board.brd, Main_Board.sch]
2016-09-23 Moved old charging circuit to directory
    [ChargingCircuit.brd, ChargingCircuit.sch]
2016-09-28 Fixed Charging board 3S connections, connected EVERYTHING to the micro
    [Main_Board.brd, Main_Board.sch]
2016-09-28 Various updates to the board
    [Main_Board.brd, Main_Board.sch]
2016-09-30 Updated some values
    [Main_Board.brd, Main_Board.sch]
2016-10-01 Addded fuses to charger, need to finish
    [Main_Board.brd, Main_Board.sch]
2016-10-03 Finalized parts
    [Main_Board.brd, Main_Board.sch]
2016-10-03 added heartbeat LED to PC13
    [Main_Board.brd, Main_Board.sch]
2016-10-03 Replaced inductor in buck regulator
    [Main_Board.brd, Main_Board.sch]
2016-10-03 Renumbered ALL elements
    [Main_Board.brd, Main_Board.sch]
2016-10-03 Minor moving around
    [Main_Board.brd, Main_Board.sch]
2016-10-03 Preliminary layout for wireless receiver done
    [Main_Board.brd, Main_Board.sch]
2016-10-03 More board movement, things are now more or less clustered now
    [Main_Board.brd, Main_Board.sch]
2016-10-03 More moving things around
    [Main_Board.brd]
2016-10-05 replaced SPI sd to SDIO
    [Main_Board.brd, Main_Board.sch]
2016-10-05 fixed board size
    [Main_Board.brd]
2016-10-05 added switch
    [Main_Board.brd, Main_Board.sch]
2016-10-05 started traces
    [Main_Board.brd, Main_Board.sch]
2016-10-05 initial layout of charging circuit
    [Main_Board.brd]
2016-10-05 added XT60
    [Main_Board.brd, Main_Board.sch]
2016-10-05 Moved the schematic
    [Main_Board.brd, Main_Board.sch]
2016-10-05 LAYOUT AAAAAAAAAAAAAAAAAAAAAAAAAAAAAAAAAAAAAAAAAAAAAAAAAAAAAAAAAAAAAAAAAAAAAAAAAAAAAAAAAAAAAAAAAAAAAAAAAAAAAAAAAAAAAAAAAAAAAAAAAAAAAAAAAAAAAAAAAAAAAAARRRRRRRRRRRRRRRRRRRRRRRRRRRRRRRRRRRRRRRRRGGGGGGGG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
    [Main_Board.brd, Main_Board.sch]
2016-10-06 MORE LAYOUT OH GOD EVERYTHING IS GOING TO FAIL
    [Main_Board.brd]
2016-10-06 removed CC-by-SA text from board
    [Main_Board.brd, Main_Board.sch]
2016-10-06 Smaller vias make me happy
    [Main_Board.brd]
2016-10-06 Minor routing progress. TODO: layout for micro parts
    [Main_Board.brd]
2016-10-06 I... I think I finished routing the charging circuit...
    [Main_Board.brd]
2016-10-06 Added Advanced Circuits design rules
2016-10-06 Changed some rects to pads
    [Main_Board.brd, Main_Board.sch]
2016-10-11 routed and placed decoupling capacitors for micro
    [Main_Board.brd, Main_Board.sch]
2016-10-12 continued power routing and more
    [Main_Board.brd]
2016-10-12 rearranged some stuff
    [Main_Board.brd, Main_Board.sch]
2016-10-12 so much routing
    [Main_Board.brd, Main_Board.sch]
2016-10-12 routed mostly everything
    [Main_Board.brd]
2016-10-13 Fixed via sizes, made routes slightly better angles (thanks, kyle)
    [Main_Board.brd]
2016-10-13 more routing fixes
    [Main_Board.brd]
2016-10-13 Added design rule checker, moved some stuff for clearance
    [Main_Board.brd]
2016-10-13 More minor fixes for the DRC, rerouting things so it doesn't yell at me (as much)
    [Main_Board.brd, Main_Board.sch]
2016-10-13 Fixed 3 drill sizes
    [Main_Board.brd]
2016-10-13 AdRedid gnd to pgnd for wireless charging circuit
    [Main_Board.brd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]
2016-10-14 Changed DRC to be 5mil
    [Main_Board.brd]
2016-10-14 Down to 33 clearance errors
    [Main_Board.brd, Main_Board.sch]
2016-10-14 Removed ALL violations
    [Main_Board.brd, Main_Board.sch]
2016-10-14 Fixed overlap issue caused by resizing
    [Main_Board.brd]
2016-10-14 Modified capacitor sizes
    [Main_Board.brd, Main_Board.sch]
2016-10-15 routed LED, added standoffs, and refined routes
    [Main_Board.brd, Main_Board.sch]
2016-10-15 Updated cap pads to be slightly larager for easy soldering
    [Main_Board.brd, Main_Board.sch]
2016-10-15 Removed LEDs and 3 pin header since it wasn't worth trying to route
    [Main_Board.brd, Main_Board.sch]
2016-10-15 added vias connecting top and bottom planes (also CAM output)
    [Main_Board.brd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]
2016-10-15 manually added new keepout layers and tstop (Chris check)
    [Main_Board.brd]
2016-10-16 Added thermal vias and rerouted some stuff
    [Main_Board.brd, Main_Board.sch]
2016-10-16 moved passives on speaker IC closer
    [Main_Board.brd]
2016-10-16 fixed clearance errors due to ground planes
    [Main_Board.brd, Main_Board.sch]
2016-10-16 Removed vias from power mosfet
    [Main_Board.brd, Main_Board.sch]
2016-10-16 Final part and layout updates (hopefully)
    [Main_Board.brd, Main_Board.sch]
2016-10-16 added trestrict
    [Main_Board.brd]
2016-10-17 Fixed clearance issues and uploaded new Gerbers
    [Main_Board.brd, Main_Board.sch]
2016-10-17 added another main fuse
    [Main_Board.brd, Main_Board.sch]
2016-10-17 added 3-pole LPF w/cutoff ~16kHz
    [Main_Board.brd, Main_Board.sch]
2016-10-17 slightly larger cap size
    [Main_Board.brd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]
2016-10-17 added soldermask to SD pad
    [Main_Board.brd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]
2016-10-17 Fixed hole sizes
    [Main_Board.brd]
2016-10-17 made SMB clock longer
    [Main_Board.brd]
2016-10-18 added current limiting resistor
    [Main_Board.brd, Main_Board.sch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]
2016-10-18 added cap between V1 and V2 of charging circuit
    [Main_Board.brd, Main_Board.sch]
2016-10-18 final final actually final iteration pls god
    [Main_Board.brd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]
